schedoska/RFID-Acces/Case_bottom.stl

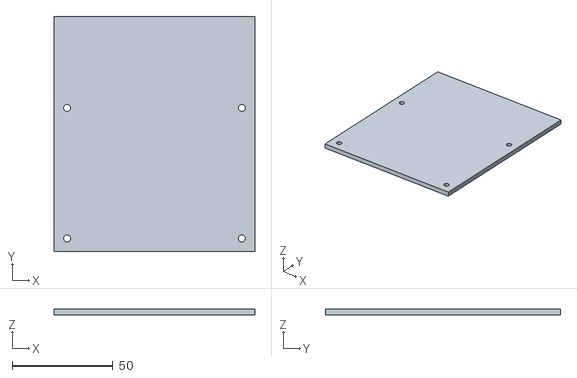
[picture p3: CAD file, 2024-06-26]
Case_bottom.stl
100.0 x 117.0 x 3.00
