schedoska/RFID-Acces/Case_top.stl

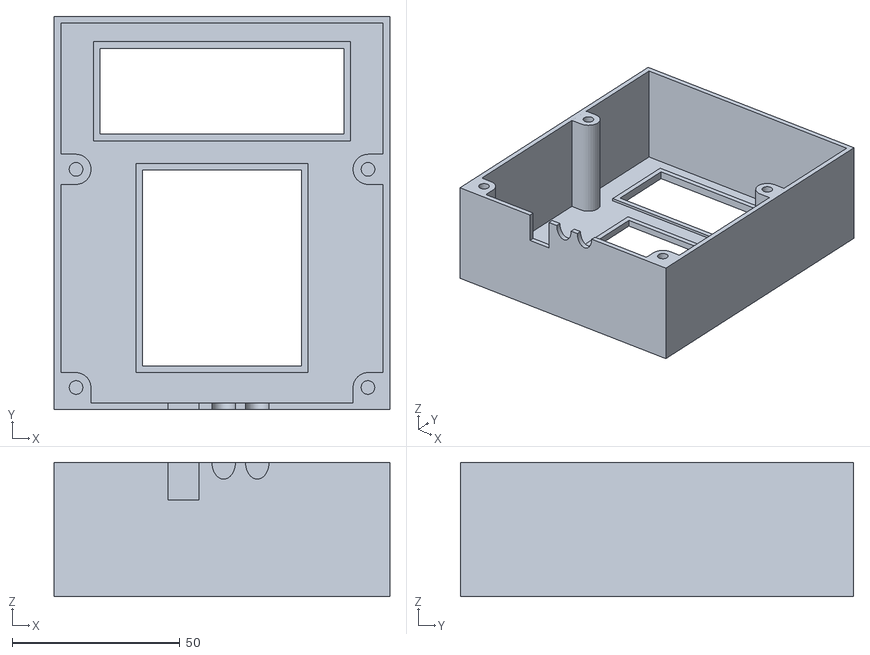
[picture p4: CAD file, 2024-06-26]
Case_top.stl
100.0 x 117.0 x 40.0
