schedoska/RFID-Acces/RFID_ver_1.1.sch

## EAGLE design RFID_ver_1.1.sch (2024-06-26)

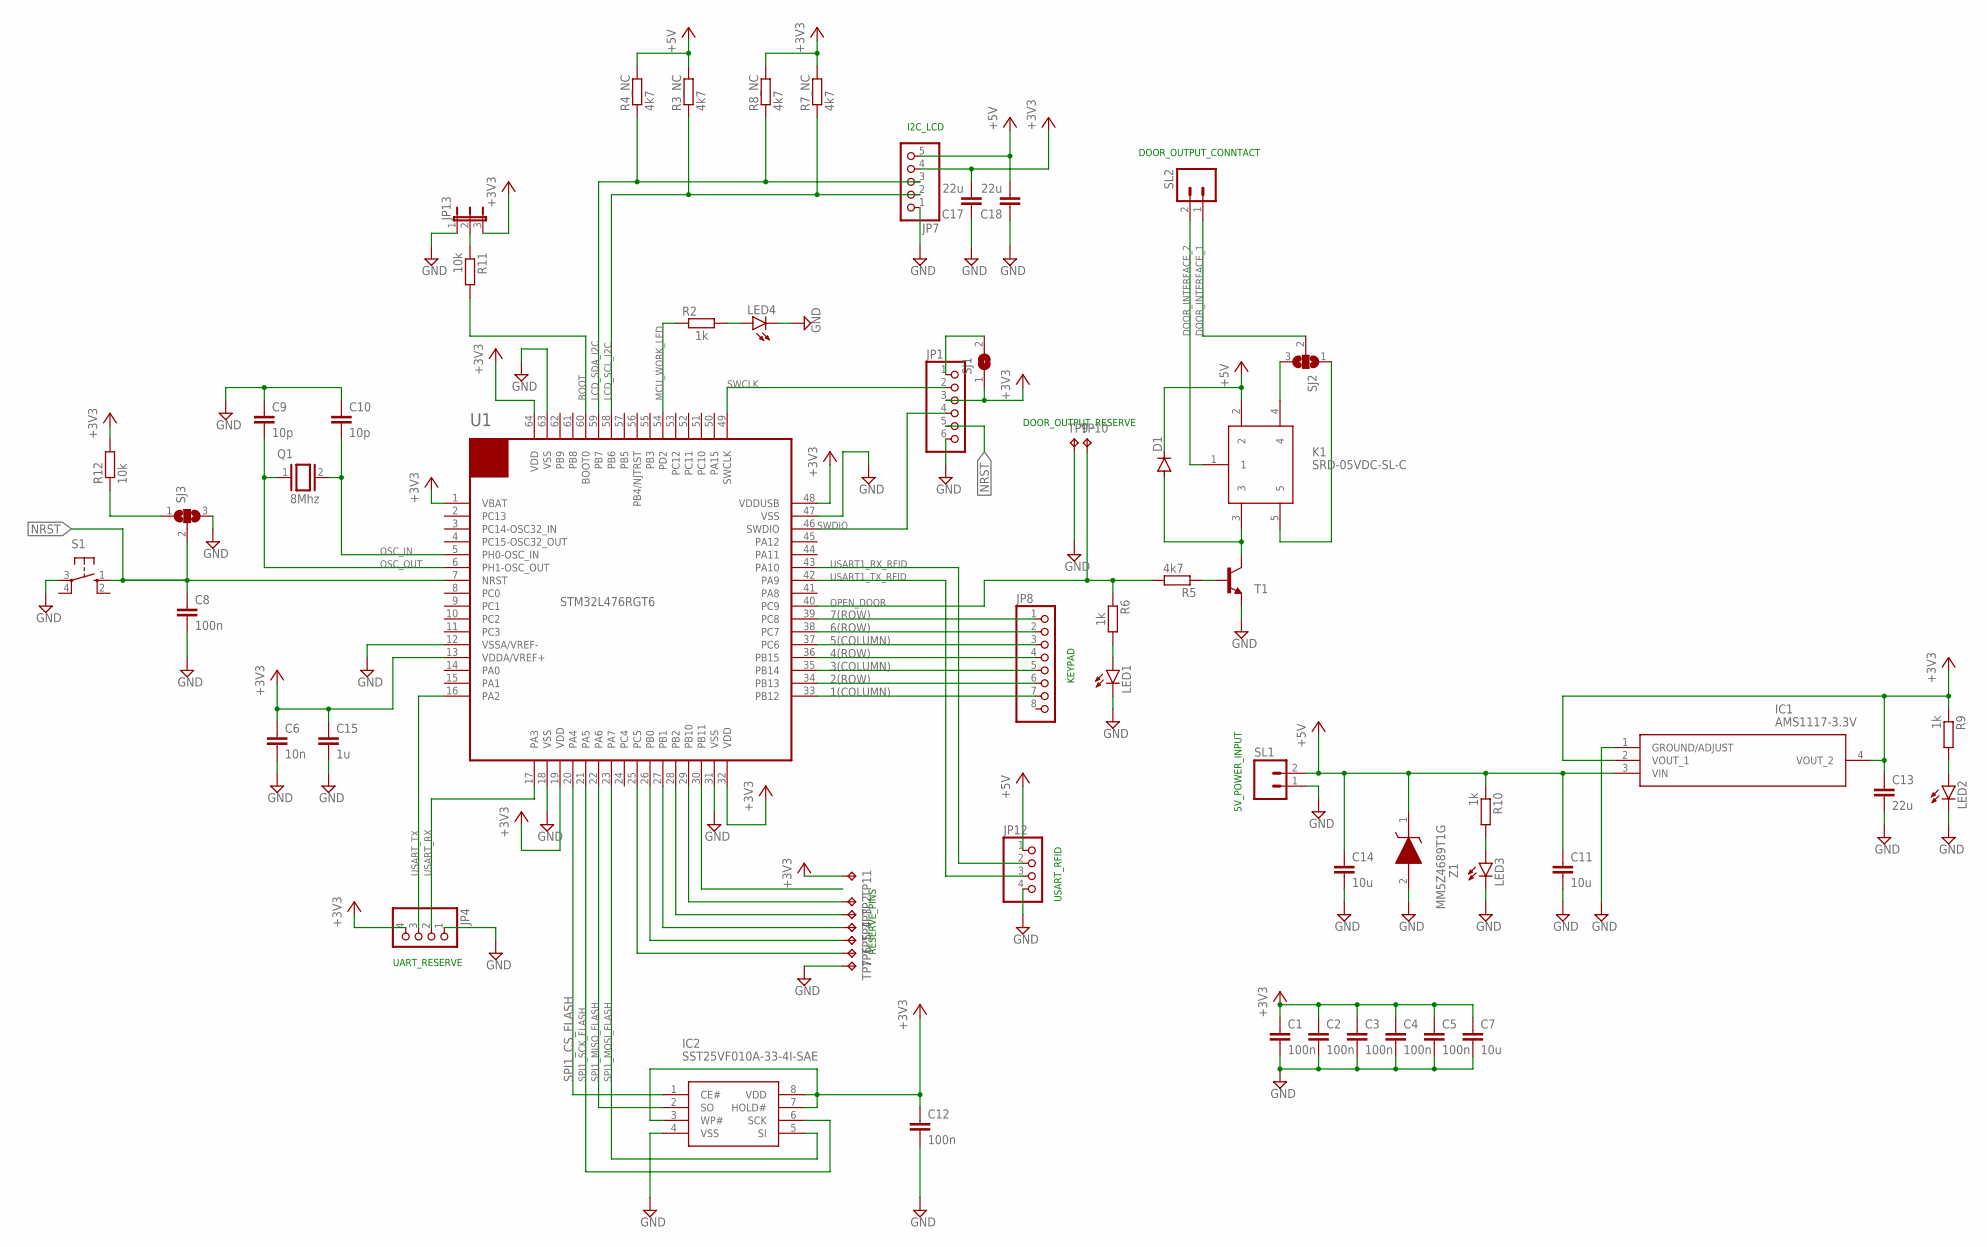
[picture p5: schematic RFID_ver_1.1.sch]

Parts:
C1, C2, C3, C4, C5, C8, C12: 100n; C0805
C6: 10n; C0805
C7, C11, C14: 10u; C0805
C9, C10: 10p; C0805
C13, C17, C18: 22u; C0805
C15: 1u; C0805
D1: DIODE-DO-214AC; DO-214AC
IC1: AMS1117-3.3V; SOT229P700X180-4N
IC2: SST25VF010A-33-4I-SAE; SOIC127P600X175-8N
JP1: PINHD-1X6; 1X06
JP4, JP12: PINHD-1X4; 1X04
JP7: PINHD-1X5; 1X05
JP8: PINHD-1X8; 1X08
JP13: JP2E; JP2
K1: SRD-05VDC-SL-C; SRD
LED1, LED2, LED3, LED4: LEDCHIP-LED0805; CHIP-LED0805
Q1: 8Mhz; QS
R2, R6, R9, R10: 1k; R0805
R3_NC, R4_NC, R5, R7_NC, R8_NC: 4k7; R0805
R11, R12: 10k; R0805
S1: 10-XX; B3F-10XX
SJ1: SJ
SJ2, SJ3: SJ2W; SJ_2
SL1, SL2: M02; 02P
T1: BC817-NPN-SOT23-BEC; SOT23-BEC
TP2, TP3, TP4, TP5, TP6, TP7, TP11: TPPAD1-13; P1-13
TP9, TP10: TPPAD1-17; P1-17
U1: STM32L476RGT6; LQFP-64
Z1: MM5Z4689T1G; SODFL1608X70N

Connections:
1(COLUMN): JP8.7, U1.33 (PB12)
2(ROW): JP8.6, U1.34 (PB13)
3(COLUMN): JP8.5, U1.35 (PB14)
4(ROW): JP8.4, U1.36 (PB15)
5(COLUMN): JP8.3, U1.37 (PC6)
6(ROW): JP8.2, U1.38 (PC7)
7(ROW): JP8.1, U1.39 (PC8)
+3V3: C1.1, C2.1, C3.1, C4.1, C5.1, C6.1, C7.1, C12.1, C13.1, C15.1, C17.2, IC1.2 (VOUT_1), IC1.4 (VOUT_2), IC2.3 (WP#), IC2.7 (HOLD#), IC2.8 (VDD), JP1.3, JP4.4, JP7.4, JP13.3, R7_NC.2, R8_NC.2, R9.1, R12.2, SJ1.1, TP11.TP, U1.1 (VBAT), U1.13 (VDDA/VREF+), U1.19 (VDD), U1.32 (VDD), U1.48 (VDDUSB), U1.64 (VDD)
+5V: C11.1, C14.1, C18.2, D1.C, IC1.3 (VIN), JP7.5, JP12.1, K1.2, R3_NC.2, R4_NC.2, R10.1, SL1.2, Z1.1 (K)
BOOT: R11.2, U1.60 (BOOT0)
DOOR_INTERFACE_1: SJ2.2, SL2.1
GND: C1.2, C2.2, C3.2, C4.2, C5.2, C6.2, C7.2, C8.2, C9.1, C10.1, C11.2, C12.2, C13.2, C14.2, C15.2, C17.1, C18.1, IC1.1 (GROUND/ADJUST), IC2.4 (VSS), JP1.6, JP4.1, JP7.1, JP12.4, JP13.1, LED1.C, LED2.C, LED3.C, LED4.C, S1.3, SJ3.3, SL1.1, T1.E, TP7.TP, TP9.TP, U1.12 (VSSA/VREF-), U1.18 (VSS), U1.31 (VSS), U1.47 (VSS), U1.63 (VSS), Z1.2 (A)
LCD_SCL_I2C: JP7.2, R3_NC.1, R7_NC.1, U1.58 (PB6)
LCD_SDA_I2C: JP7.3, R4_NC.1, R8_NC.1, U1.59 (PB7)
MCU_WORK_LED: R2.1, U1.54 (PD2)
unnamed: LED4.A, R2.2
unnamed: C10.2, Q1.2, U1.5 (PH0-OSC_IN)
unnamed: JP1.1, SJ1.2
unnamed: R5.1, T1.B
unnamed: LED1.A, R6.2
unnamed: D1.A, K1.3, T1.C
unnamed: K1.1, SL2.2
unnamed: K1.4, SJ2.3
unnamed: LED2.A, R9.2
unnamed: JP12.3, U1.42 (PA9)
unnamed: K1.5, SJ2.1
unnamed: LED3.A, R10.2
unnamed: R12.1, SJ3.1
unnamed: JP13.2, R11.1
unnamed: TP2.TP, U1.29 (PB10)
unnamed: TP3.TP, U1.28 (PB2)
unnamed: TP4.TP, U1.27 (PB1)
unnamed: TP5.TP, U1.26 (PB0)
unnamed: TP6.TP, U1.25 (PC5)
NRST: C8.1, JP1.5, S1.1 (S), SJ3.2, U1.7 (NRST)
OPEN_DOOR: R5.2, R6.1, TP10.TP, U1.40 (PC9)
OSC_OUT: C9.2, Q1.1, U1.6 (PH1-OSC_OUT)
SPI1_CS_FLASH: IC2.1 (CE#), U1.20 (PA4)
SPI1_MISO_FLASH: IC2.2 (SO), U1.22 (PA6)
SPI1_MOSI_FLASH: IC2.5 (SI), U1.23 (PA7)
SPI1_SCK_FLASH: IC2.6 (SCK), U1.21 (PA5)
SWCLK: JP1.2, U1.49 (SWCLK)
SWDIO: JP1.4, U1.46 (SWDIO)
USART1_RX_RFID: JP12.2, U1.43 (PA10)
USART_RX: JP4.2, U1.17 (PA3)
USART_TX: JP4.3, U1.16 (PA2)

Notes on the sheet:
RESERVE_PINS
USART_RFID
KEYPAD
DOOR_OUTPUT_RESERVE
DOOR_OUTPUT_CONNTACT
I2C_LCD
UART_RESERVE
5V_POWER_INPUT
