schedoska/RFID-Acces/RFID_STM32/Core/Src/main.c

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
/* Includes ------------------------------------------------------------------*/
#include "main.h"

/* USER CODE BEGIN Includes */
#include "app.h"
/* USER CODE END Includes */

I2C_HandleTypeDef hi2c1;

SPI_HandleTypeDef hspi1;

TIM_HandleTypeDef htim2;

UART_HandleTypeDef huart1;

void SystemClock_Config(void);
static void MX_GPIO_Init(void);
static void MX_I2C1_Init(void);
static void MX_USART1_UART_Init(void);
static void MX_TIM2_Init(void);
static void MX_SPI1_Init(void);
/* USER CODE BEGIN 0 */
TIM_HandleTypeDef tim2;
UART_HandleTypeDef uart1;
SPI_HandleTypeDef spi1;
/* USER CODE END 0 */

/**
  * @brief  The application entry point.
  * @retval int
  */
int main(void)
{
  /* MCU Configuration--------------------------------------------------------*/

  /* Reset of all peripherals, Initializes the Flash interface and the Systick. */
  HAL_Init();

  /* Configure the system clock */
  SystemClock_Config();

  /* Initialize all configured peripherals */
  HAL_Delay(200);

  MX_GPIO_Init();
  MX_I2C1_Init();
  MX_USART1_UART_Init();
  MX_TIM2_Init();
  MX_SPI1_Init();
  /* USER CODE BEGIN 2 */

  HAL_Delay(100);

  lcd_init(&hi2c1);
  HAL_Delay(30);
  lcd_clear(&hi2c1);
  keypad_init();
  tim2 = htim2;
  TIM2->CR1 = 0;
  HAL_TIM_Base_Start_IT(&tim2);

  spi1 = hspi1;
  flash_init();
  flash_download_tag_data();

  HAL_UART_Init(&huart1);
  uart1 = huart1;
  HAL_UART_Receive_IT (&huart1, RFID_buffer, 14);


    // czyszczenie strony
    /*HAL_GPIO_WritePin(GPIOA, GPIO_PIN_4, GPIO_PIN_RESET);
     uint8_t data = 0x06;
      HAL_SPI_Transmit(&hspi1, &data, 1, 500);
      HAL_GPIO_WritePin(GPIOA, GPIO_PIN_4, GPIO_PIN_SET);
      HAL_Delay(300);

    HAL_GPIO_WritePin(GPIOA, GPIO_PIN_4, GPIO_PIN_RESET);
    data = 0x20;
    HAL_SPI_Transmit(&hspi1, &data, 1, 500);
    data = 0x01;
    HAL_SPI_Transmit(&hspi1, &data, 1, 500);
    data = 0x01;
    HAL_SPI_Transmit(&hspi1, &data, 1, 500);
    data = 0x11;
    HAL_SPI_Transmit(&hspi1, &data, 1, 500);
    HAL_GPIO_WritePin(GPIOA, GPIO_PIN_4, GPIO_PIN_SET);
          HAL_Delay(300);


  uint8_t tab[6] = {'5','7','5','B','D','C'};
  uint8_t taba[6];
  flash_write_byte(1, TAG_COUNT_ADDRES);
  flash_write_byte_array(tab, 6, TAG_FIRST_ADDRES);

  flash_download_tag_data();
  lcd_send_text(flash_tag_buffor[0], &hi2c1);*/

  /*flash_erase_block(MAIN_SECTION_ADDRES);
  flash_correct_password_buffor[0] = '1';
  flash_correct_password_buffor[1] = '3';
  flash_correct_password_buffor[2] = '3';
  flash_correct_password_buffor[3] = '7';
  flash_update_memory_content();*/

  /* USER CODE END 2 */

  /* Infinite loop */
  /* USER CODE BEGIN WHILE */
  while (1)
  {
	app_main_loop(&hi2c1);
	HAL_Delay(100);
	HAL_GPIO_TogglePin(GPIOD, GPIO_PIN_2);

    /* USER CODE END WHILE */

    /* USER CODE BEGIN 3 */
  }
  /* USER CODE END 3 */
}

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
