schedoska/RFID-Acces/RFID_STM32/RFID_KPZ.ioc

Mcu.UserName=STM32L476RGTx
PA10.Signal=USART1_RX
PA4.Signal=GPIO_Output
PA5.Signal=SPI1_SCK
PA6.Signal=SPI1_MISO
PA7.Signal=SPI1_MOSI
PA9.Signal=USART1_TX
PB12.Signal=GPIO_Input
PB13.Signal=GPIO_Output
PB14.Signal=GPIO_Input
PB15.Signal=GPIO_Output
PB6.Signal=I2C1_SCL
PB7.Signal=I2C1_SDA
PC6.Signal=GPIO_Input
PC7.Signal=GPIO_Output
PC8.Signal=GPIO_Output
PC9.Signal=GPIO_Output
PD2.Signal=GPIO_Output
